maslohaslo1234-spec/electrotrack/BOM.md

# electrotrack – bill of materials

<!-- Generated by Half Life from project cmuva2sdt0fjm01smhur2xi6g. Edits here are overwritten on the next sync. -->
<!-- Generated: 2026-10-11T20:52:01.765Z -->

> [!NOTE]
> This parts list is mirrored from [Half Life](https://halflife.hackclub.com). Editing it here will not change the platform's copy, and the next sync overwrites this file.

| Week | Tier | Parts funding |
| --- | --- | --- |
| Week 1 | Tier 1 | $30.00 |

| Part | What it's for | Qty | Unit | Total | Vendor |
| --- | --- | --- | --- | --- | --- |
| [PCB](https://jlcpcb.com) | connecting everything | 1 | $2.00 | $2.00 | [jlcpcb](https://jlcpcb.com) |
| [IRLZ44NPBF](https://botland.com.pl/n-mosfet/1950-n-mosfet-irlz44n-55v47a-tht-5szt-5904422373276.html) | Switches the 4 coils, plus 1 spare | 1 | $7.63 | $7.63 | [botland](https://botland.com.pl/n-mosfet/1950-n-mosfet-irlz44n-55v47a-tht-5szt-5904422373276.html) |
| [1N5819 Schottky diode](https://botland.com.pl/diody-schottky/178-dioda-schottky-1n5822-3a-40v-10-szt-5903351244497.html) | Protects the 5 V rail from USB back-feed | 1 | $1.38 | $1.38 | [botland](https://botland.com.pl/diody-schottky/178-dioda-schottky-1n5822-3a-40v-10-szt-5903351244497.html) |
| [XT30UPB-M XT30 PCB socket](https://botland.com.pl/zlacza-do-akumulatorow/24155-gniazdo-xt30u-f-zlacze-zenskie-wysokopradowe-5szt.html) | Battery input connector | 1 | $3.80 | $3.80 | [botland](https://botland.com.pl/zlacza-do-akumulatorow/24155-gniazdo-xt30u-f-zlacze-zenskie-wysokopradowe-5szt.html) |
| [JST XH XHP-3 housing](https://botland.com.pl/zlacza-raster-254mm/19558-zestaw-zlacz-justpi-jst-xh254-2345-pin-meskiezenskie-i-pinow-zenskich-do-obudowy-gniazda-230szt-5904422328559.html) | Plugs for the IR sensor cables | 1 | $5.87 | $5.87 | [botland](https://botland.com.pl/zlacza-raster-254mm/19558-zestaw-zlacz-justpi-jst-xh254-2345-pin-meskiezenskie-i-pinow-zenskich-do-obudowy-gniazda-230szt-5904422328559.html) |
| **Parts subtotal** | — | — | — | **$20.68** | — |
| **Tax & shipping** | — | — | — | **$8.00** | — |
| **Total** | — | — | — | **$28.68** | — |

$1.32 left of the tier's funding.
