maslohaslo1234-spec/electrotrack/BOM.csv

Item | Qty | Supplier | Cost/item | Total Cost | link
PCB | 1 | jlcpcb | $2.00 | $2.00 | https://jlcpcb.com
IRLZ44NPBF | 1 | botland | $7.63 | $7.63 | https://botland.com.pl/n-mosfet/1950-n-mosfet-irlz44n-55v47a-tht-5szt-5904422373276.html
1N5819 Schottky diode | 1 | botland | $1.38 | $1.38 | https://botland.com.pl/diody-schottky/178-dioda-schottky-1n5822-3a-40v-10-szt-5903351244497.html
XT30UPB-M XT30 PCB socket | 1 | botland | $3.80 | $3.80 | https://botland.com.pl/zlacza-do-akumulatorow/24155-gniazdo-xt30u-f-zlacze-zenskie-wysokopradowe-5szt.html
JST XH XHP-3 housing | 1 | botland | $5.87 | $5.87 | https://botland.com.pl/zlacza-raster-254mm/19558-zestaw-zlacz-justpi-jst-xh254-2345-pin-meskiezenskie-i-pinow-zenskich-do-obudowy-gniazda-230szt-5904422328559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
Estimated total shipping | 1 |  |  | $8.00
