maslohaslo1234-spec/electrotrack/hardware/electrotrack.csv

Id | Designator | Footprint | Quantity | Designation | Supplier and ref
1 | C1 | CP_Radial_D10.0mm_P5.00mm | 1 | electrolitic 1000μF
2 | C2 | C_Disc_D5.0mm_W2.5mm_P5.00mm | 1 | C 100nF
3 | C3 | CP_Radial_D6.3mm_P2.50mm | 1 | 100 µF
4 | C4 | C_Disc_D5.0mm_W2.5mm_P5.00mm | 1 | 100nF
5 | D1, D2, D3, D4 | D_DO-201AD_P15.24mm_Horizontal | 4 | SB560
6 | D5 | D_DO-41_SOD81_P10.16mm_Horizontal | 1 | 1N5819
7 | F1 | Fuseholder_Clip-5x20mm_Littelfuse_520_Inline_P20.50x5.80mm_D1.30mm_Horizontal | 1 | 5A fast
8 | J1, J2, J3, J4 | JST_XH_B3B-XH-A_1x03_P2.50mm_Vertical | 4 | IR
9 | J5 | AMASS_XT30UPB-M_1x02_P5.0mm_Vertical | 1 | XT30
10 | J6, J7, J8, J9 | TerminalBlock_Phoenix_MKDS-1,5-2-5.08_1x02_P5.08mm_Horizontal | 4 | Coil
11 | J10 | PinSocket_1x04_P2.54mm_Vertical | 1 | 0.96 inch OLED
12 | J11 | PinSocket_1x10_P2.54mm_Vertical | 1 | Conn_01x10_Pin
13 | Q1, Q2, Q3, Q4 | TO-220-3_Vertical | 4 | IRLZ44N
14 | R1, R2, R3, R4 | R_Axial_DIN0207_L6.3mm_D2.5mm_P10.16mm_Horizontal | 4 | 10k Ω
15 | R5, R6, R7, R8 | R_Axial_DIN0207_L6.3mm_D2.5mm_P10.16mm_Horizontal | 4 | 150Ω
16 | R9, R10, R11, R12 | R_Axial_DIN0207_L6.3mm_D2.5mm_P10.16mm_Horizontal | 4 | 100Ω
17 | R13, R14, R15, R16 | R_Axial_DIN0207_L6.3mm_D2.5mm_P10.16mm_Horizontal | 4 | 10kΩ
18 | SW1 | TerminalBlock_Phoenix_MKDS-1,5-2-5.08_1x02_P5.08mm_Horizontal | 1 | SW_SPST
19 | U1 | ESP32_30pin | 1 | ~
20 | U2 | TO-220-3_Vertical | 1 | L7805
