maslohaslo1234-spec/electrotrack/pdf/electrotrack-B_Mask.pdf

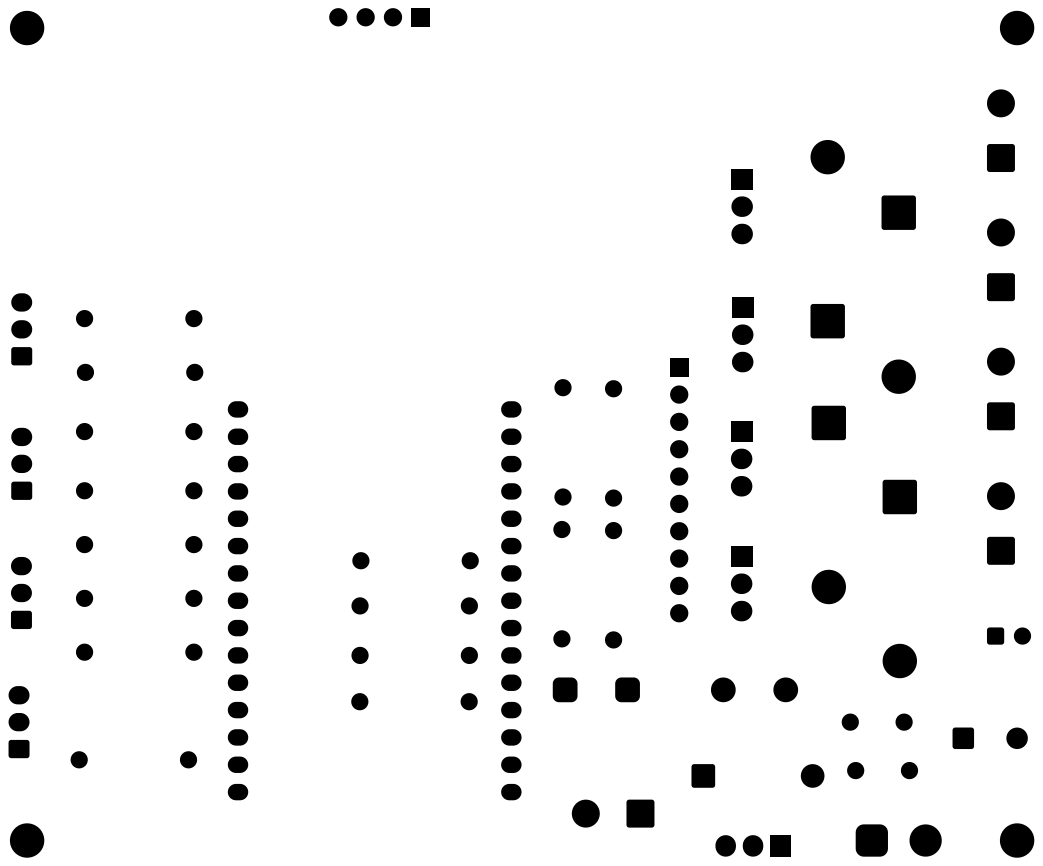
[picture p1: page 1]
