maslohaslo1234-spec/electrotrack/pdf/electrotrack-Back.pdf

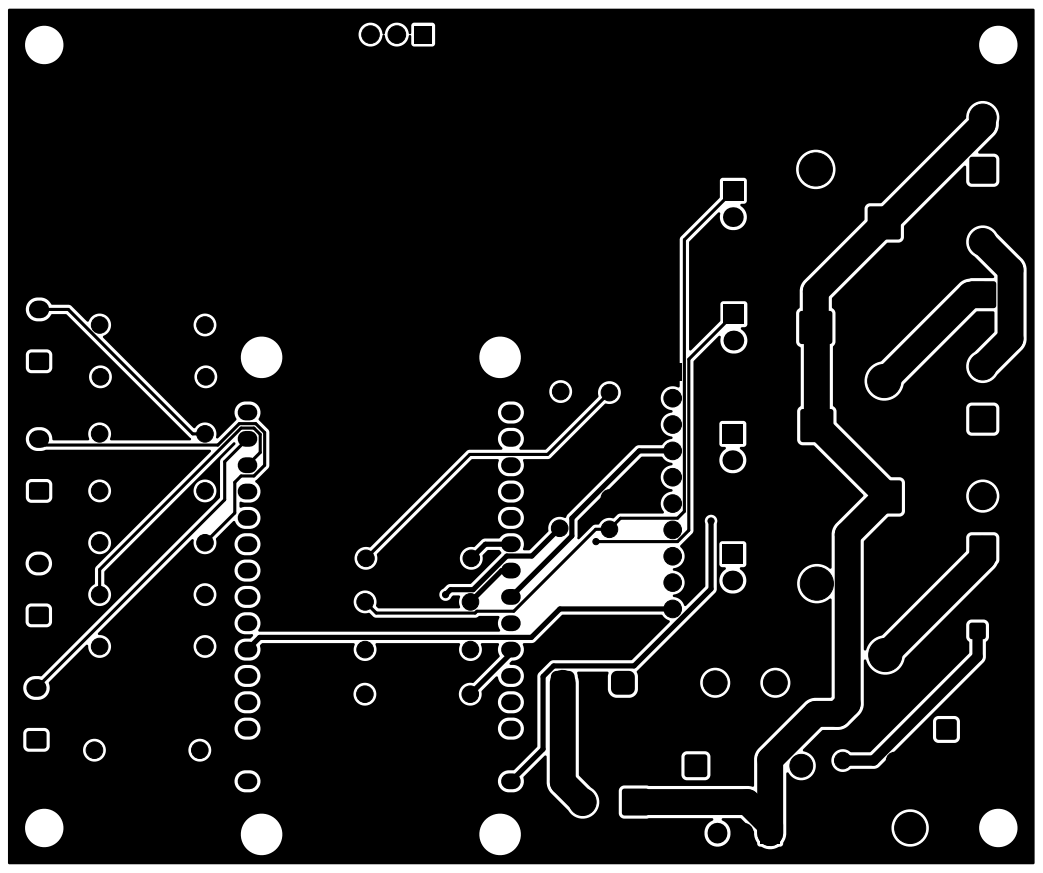
[picture p2: page 1]
