maslohaslo1234-spec/electrotrack/pdf/electrotrack-Edge_Cuts.pdf

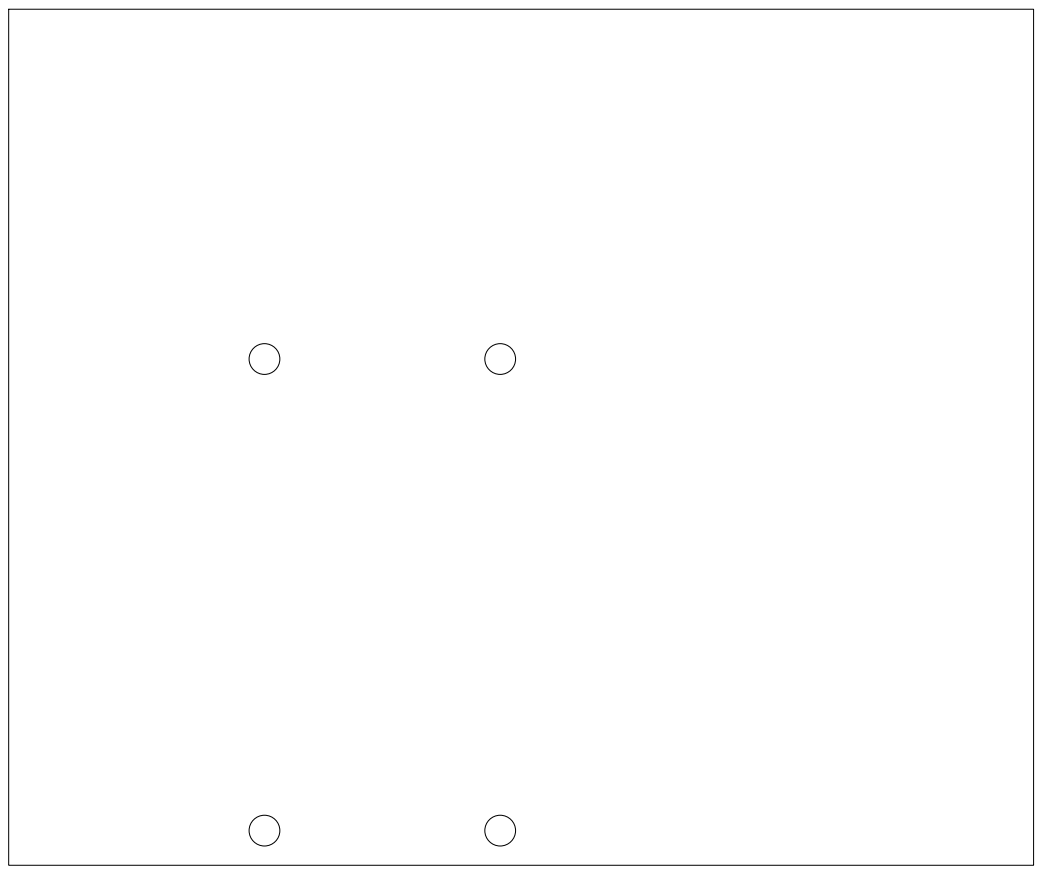
[picture p3: page 1]
