maslohaslo1234-spec/electrotrack/pdf/electrotrack-F_Silkscreen.pdf

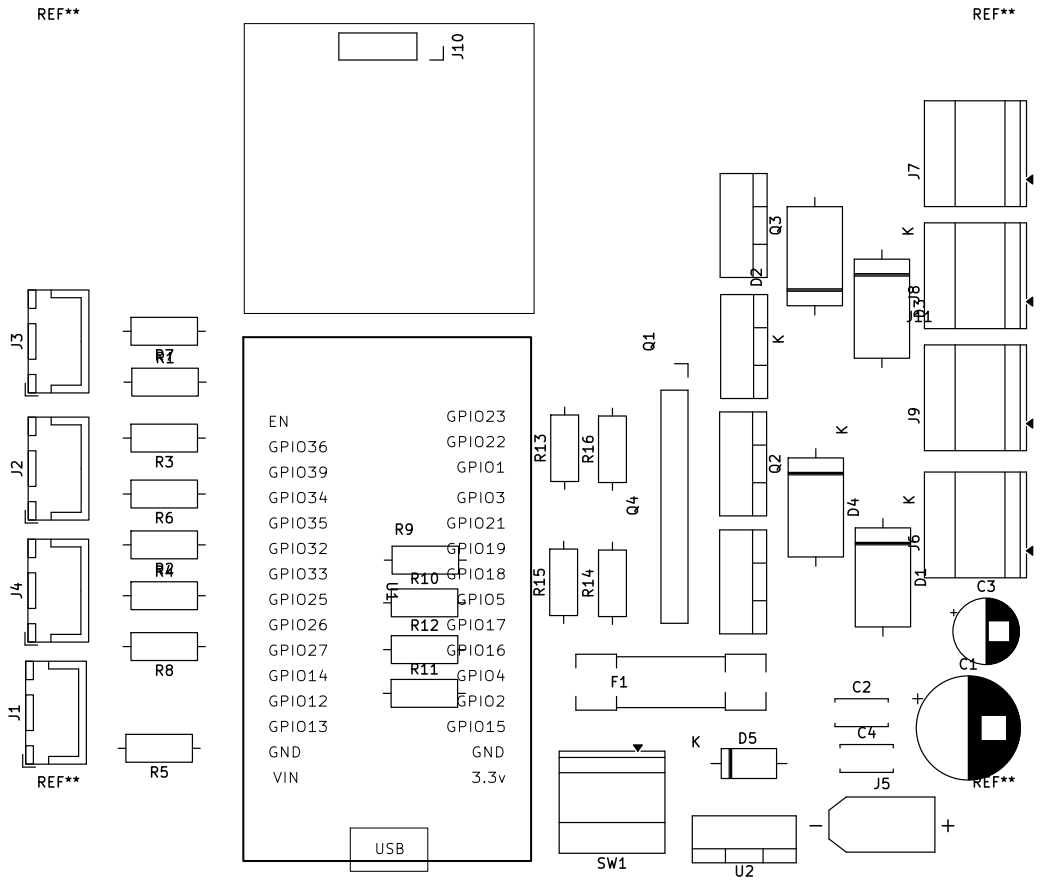
[picture p4: page 1]
