maslohaslo1234-spec/electrotrack/pdf/electrotrack-Front.pdf

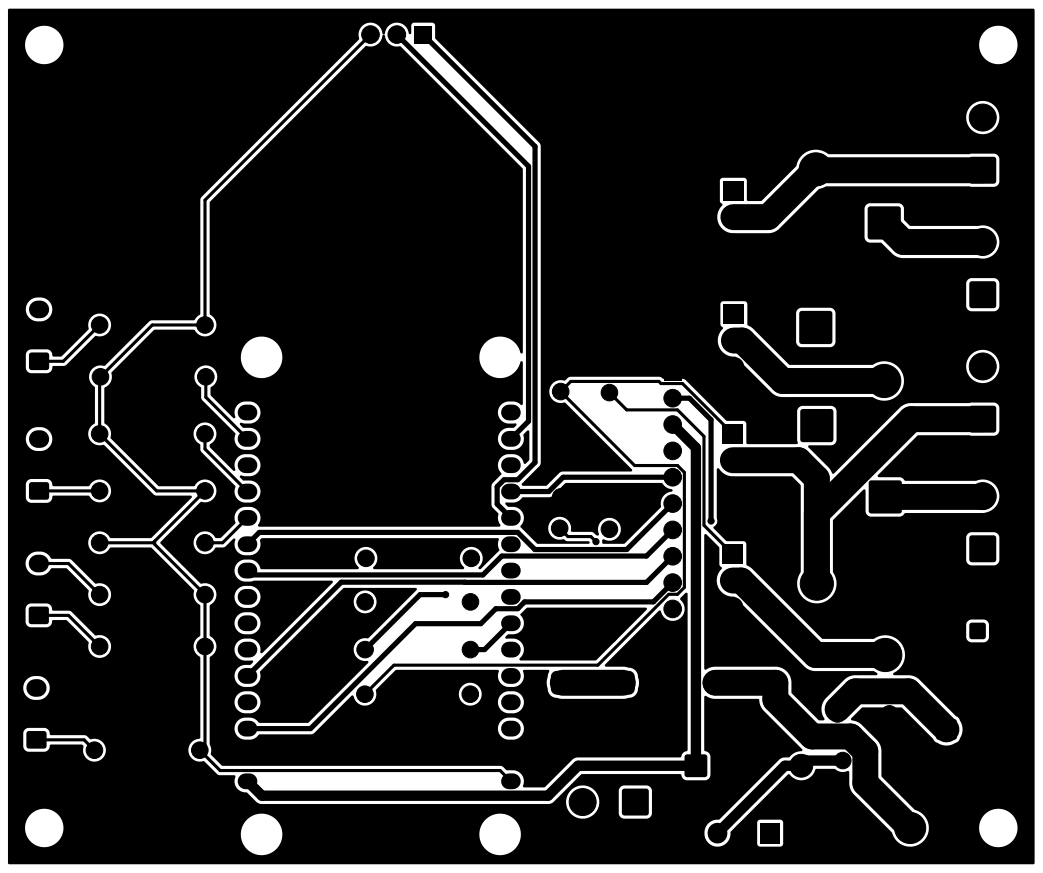
[picture p5: page 1]
