maslohaslo1234-spec/electrotrack/hardware/electrotrack.kicad_pcb

## KiCad design hardware/electrotrack.kicad_pcb (2026-10-11)

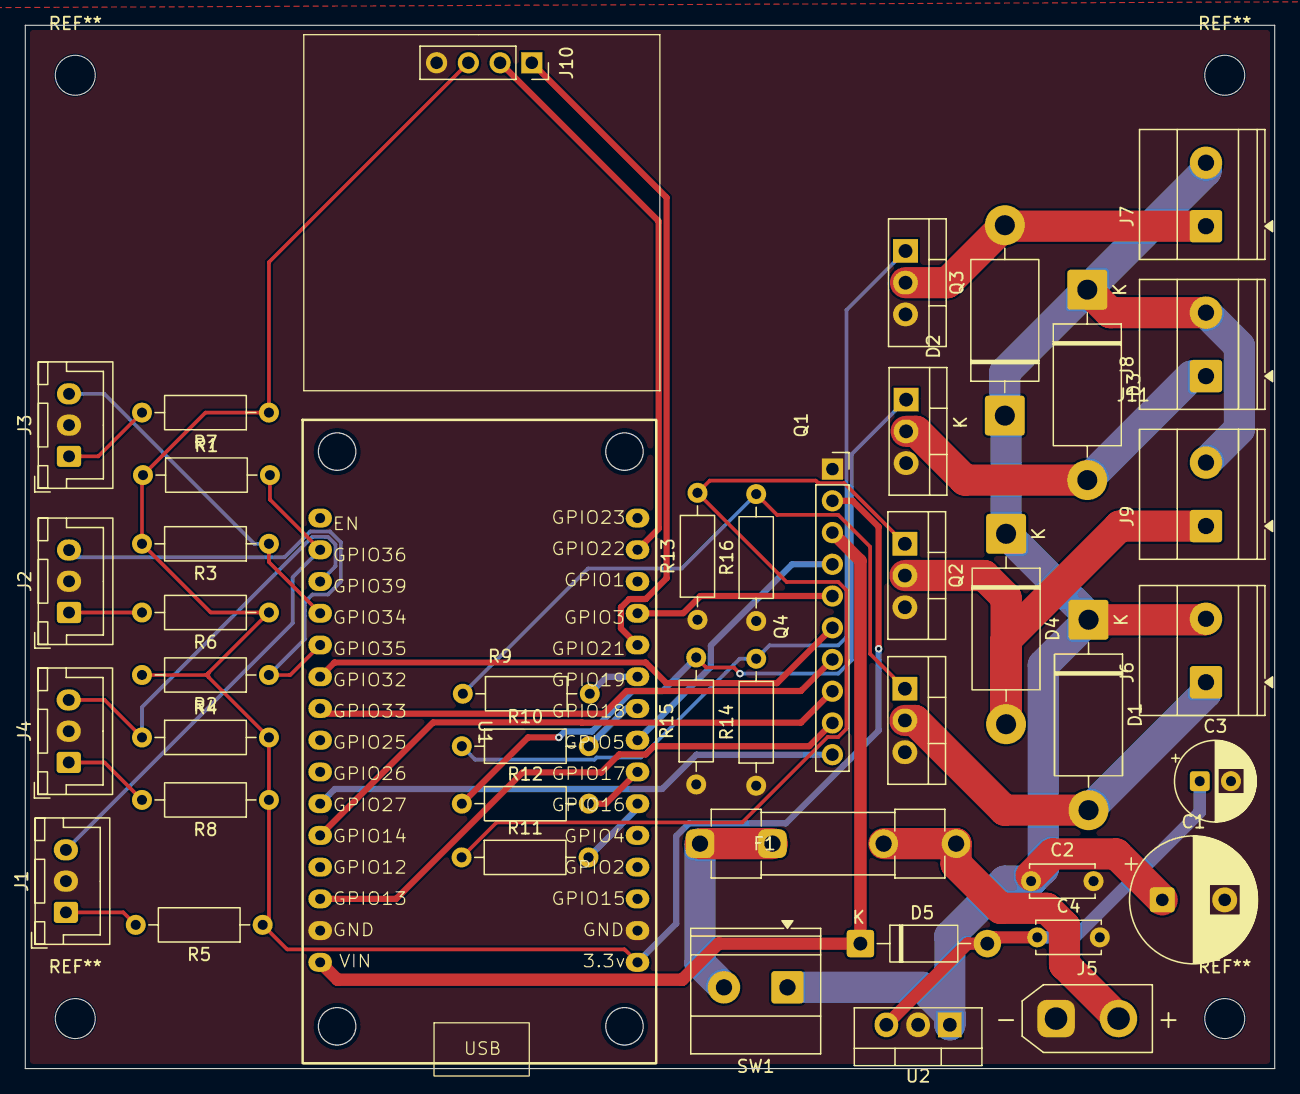
[picture p6: board electrotrack.kicad_pcb from above]

Board: 2 copper layers, 100.0 x 83.5 mm, 44 parts (0 on the bottom side), 36 nets.

Parts:
C1: electrolitic 1000μF; CP_Radial_D10.0mm_P5.00mm
C2: C 100nF; C_Disc_D5.0mm_W2.5mm_P5.00mm
C3: 100 µF; CP_Radial_D6.3mm_P2.50mm
C4: 100nF; C_Disc_D5.0mm_W2.5mm_P5.00mm
D1, D2, D3, D4: SB560; D_DO-201AD_P15.24mm_Horizontal
D5: 1N5819; D_DO-41_SOD81_P10.16mm_Horizontal
F1: 5A fast; Fuseholder_Clip-5x20mm_Littelfuse_520_Inline_P20.50x5.80mm_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
J1, J2, J3, J4: IR; JST_XH_B3B-XH-A_1x03_P2.50mm_Vertical
J5: XT30; AMASS_XT30UPB-M_1x02_P5.0mm_Vertical
J6, J7, J8, J9: Coil; TerminalBlock_Phoenix_MKDS-1,5-2-5.08_1x02_P5.08mm_Horizont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
J10: 0.96 inch OLED; PinSocket_1x04_P2.54mm_Vertical
J11: Conn_01x10_Pin; PinSocket_1x10_P2.54mm_Vertical
Q1, Q2, Q3, Q4: IRLZ44N; TO-220-3_Vertical
R1, R2, R3, R4: 10k Ω; R_Axial_DIN0207_L6.3mm_D2.5mm_P10.16mm_Horizontal
R5, R6, R7, R8: 150Ω; R_Axial_DIN0207_L6.3mm_D2.5mm_P10.16mm_Horizontal
R9, R10, R11, R12: 100Ω; R_Axial_DIN0207_L6.3mm_D2.5mm_P10.16mm_Horizontal
R13, R14, R15, R16: 10kΩ; R_Axial_DIN0207_L6.3mm_D2.5mm_P10.16mm_Horizontal
SW1: SW_SPST; TerminalBlock_Phoenix_MKDS-1,5-2-5.08_1x02_P5.08mm_Horizont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
U1: ESP32_30pin
U2: L7805; TO-220-3_Vertical

Connections:
+3.3V: J10.3, J11.2, R1.1, R2.2, R3.2, R4.2, R5.1, R6.1, R7.1, R8.1, U1.16 (3.3v)
+5V: D5.1 (K), J11.3, U1.1 (VIN)
+12V: C1.1, C2.1, D1.1 (K), D2.1 (K), D3.1 (K), D4.1 (K), J6.2, J7.2, J8.2, J9.2, SW1.1 (A), U2.1 (IN)
GND: C1.2, C2.2, C3.2, C4.2, J1.2, J2.2, J3.2, J4.2, J5.1, J10.4, J11.1, Q1.3 (S), Q2.3 (S), Q3.3 (S), Q4.3 (S), R13.1, R14.1, R15.1, R16.1, U1.2 (GND), U1.17 (GND), U2.2 (GND)
unnamed: D1.2 (A), J6.1, Q4.2 (D)
unnamed: D2.2 (A), J7.1, Q3.2 (D)
unnamed: D3.2 (A), J8.1, Q1.2 (D)
unnamed: D4.2 (A), J9.1, Q2.2 (D)
unnamed: C3.1, C4.1, D5.2 (A), U2.3 (OUT)
unnamed: J1.1, R5.2
unnamed: J1.3, R1.2, U1.14 (GPIO36)
unnamed: J2.1, R6.2
unnamed: J2.3, R2.1, U1.11 (GPIO35)
unnamed: J3.1, R7.2
unnamed: J3.3, R3.1, U1.12 (GPIO34)
unnamed: J4.1, R8.2
unnamed: J4.3, R4.1, U1.13 (GPIO39)
unnamed: F1.2, J5.2
unnamed: J10.1, U1.26 (GPIO21)
unnamed: J10.2, U1.29 (GPIO22)
unnamed: J11.4, U1.23 (GPIO5)
unnamed: J11.5, U1.27 (GPIO3)
unnamed: J11.6, U1.10 (GPIO32)
unnamed: J11.7, U1.9 (GPIO33)
unnamed: J11.8, U1.5 (GPIO14)
unnamed: J11.9, U1.3 (GPIO13)
unnamed: J11.10, U1.6 (GPIO27)
unnamed: Q1.1 (G), R12.1, R15.2
unnamed: Q2.1 (G), R11.1, R13.2
unnamed: Q3.1 (G), R10.1, R14.2
unnamed: Q4.1 (G), R9.1, R16.2
unnamed: F1.1, SW1.2 (B)
unnamed: R11.2, U1.21 (GPIO16)
unnamed: R12.2, U1.22 (GPIO17)
unnamed: R10.2, U1.24 (GPIO18)
unnamed: R9.2, U1.25 (GPIO19)
