maslohaslo1234-spec/electrotrack/JOURNAL.md

# electrotrack – devlog

<!-- Generated by Half Life from project cmuva2sdt0fjm01smhur2xi6g. Edits here are overwritten on the next sync. -->
<!-- Generated: 2026-10-11T19:37:45.149Z -->

> [!NOTE]
> This devlog is mirrored from [Half Life](https://halflife.hackclub.com) – [open the project](https://halflife.hackclub.com/projects/cmuva2sdt0fjm01smhur2xi6g). Editing it here will not change the platform's copy, and the next sync overwrites this file.

> Electrotrack is a multi-stage electromagnetic ball accelerator (coilgun) with a custom PCB. An ESP32 reads IR photo-interrupters along a 3D-printed track and fires a sequence of coils to pull a steel ball forward. Each coil is switched off as the ball reaches its center, so it isn't pulled back. Hardware - ESP32 controller, 4 coil channels (logic-level N-MOSFETs + flyback diodes) - Coils wound from 0.3 mm copper wire - 3S LiPo (≈12 V)  - IR position sensors salvaged from a photocopier - 7.5 mm steel ball *Inspired by Hyperspace Pirate's electromagnetic accelerator project.*

| Week | Tier | Hours logged | Entries |
| --- | --- | --- | --- |
| Week 1 | Tier 1 | 21.68h | 2 |

## Contents

1. [2026-10-06 – ## Week 1 – Entry 1: Concept, schematic and idea reel](#2026-10-06-week-1-entry-1-concept-schematic-and-idea-reel)
2. [2026-10-11 – Week 1 – Entry 2: KiCad schematic, PCB layout and routing](#2026-10-11-week-1-entry-2-kicad-schematic-pcb-layout-and-rou)

## Design

### 2026-10-06 – ## Week 1 – Entry 1: Concept, schematic and idea reel

**10h**

## Week 1 – Entry 1: Concept, schematic and idea reel

**Total time: ~10 h over two days**

* ~2.5 h: hand-drawn schematic + research
* ~2.5 h: thinking through decisions + filming initial clips
* ~3.5 h: filming remaining footage & editing the reel
* ~1.5 h: writing & publishing Entry 1
---

### Day 1 (05.10, 4:00pm–9:00pm): Ideas, decisions and schematic

**How it started**
I watched Hyperspace Pirate's video *"Electromagnetic Accelerator Improvements Part II"* and realized that building something similar was well within reach. That's when I decided to make it my Half-Life project, featuring a custom PCB to control the system.

> *Inspiration: Hyperspace Pirate's Electromagnetic Accelerator project*
inspiration

**Design decisions**

- **Power:** 3S LiPo battery (already on hand).
- **Coils:** Wound from 0.3 mm copper wire (plenty available). Planning 4 coils for the initial setup.

> *Coils match-cut*
coils

> *0.3 mm copper wire spool and 3S LiPo battery*
wire and battery

- **Projectile:** Found two steel balls (7.5 mm and 12 mm). Testing both to determine the optimal choice.

> *Candidate projectiles: 7.5 mm and 12 mm steel balls*
Projectile

- **Mechanics:** 3D-printed guide track and structure.
- **Controller:** ESP32 microcontroller instead of a purely analog timing circuit. It provides precise timing control and allows dedicated firmware development.

> *ESP32 microcontroller board match-cut*
esp32

- **Sensors:** Salvaged IR photo-interrupters from an old photocopier, eliminating the need to purchase new sensors.

> *IR sensors match-cut*
IR

> *Close-up of the salvaged IR sensor components*
IR sens

**Schematic**
I carefully drew the complete circuit by hand on paper (~3 hours including research): featuring an ESP32, 4 MOSFET channels, coil drivers with flyback diodes, IR position sensors, and power regulation (12 V input to L7805 5 V regulator feeding the ESP32 VIN). The rest of the afternoon was spent refining decisions and recording footage for the video reel.

> *Drafting the circuit schematic by hand*


> *Completed hand-drawn schematic diagram*
schematic

**Problems & Solutions**

- **Bare IR sensors:** They consist only of raw IR LEDs and phototransistors. Added 220 Ω current-limiting resistors for LEDs and 10 kΩ external pull-up resistors for phototransistors, as ESP32 input-only pins lack internal pull-ups.
- **Powering ESP32 from 12 V:** Lacking a buck converter, I utilized an L7805 linear regulator. Heat dissipation will be managed with a small heatsink.
- **ESP32 pin selection:** Avoided strapping pins during boot and mapped all IR sensor inputs to dedicated input-only pins (GPIs).

---

### Day 2 (06.10, 8:30am–12:45pm): The idea reel

I dedicated the entire morning session to producing the video reel. With limited video editing experience, polishing the video took considerable time. This is my first fully edited project video in English.

- Executed a clean match-cut transition from the paper schematic to physical components.

> *Match-cut transition: paper schematic to real hardware*
match cut

---

### Day 2 (06.10, 6:30pm–8:00pm): Entry 1

Finalized and published the Entry 1 log, organizing footage, GIF demonstrations, and technical documentation.

---

### Still to check / Next steps

- Measure coil DC resistance and calculate peak current draw at 12 V (0.3 mm wire has low DC resistance).
- Select MOSFET gate resistors and pull-down resistors.
- **Next:** Transfer schematic to KiCad, generate the Bill of Materials (BOM), and layout the PCB.

### 2026-10-11 – Week 1 – Entry 2: KiCad schematic, PCB layout and routing

**11.68h**

Week 1 – Entry 2: KiCad schematic, PCB layout and routing
Total time: ~7.2 h (recorded in timelapses)

* ~3 h: KiCad schematic, footprints and BOM
* ~2 h: component placement + OLED and spare-GPIO headers
* ~1 h: routing the 2-layer board
* ~1 h: DRC fixes, Gerber/BOM export and GitHub repo
* ~1 h: editing the timelapse reel & writing Entry 2

Day 3 (07.10): KiCad schematic, footprints and BOM
I redrew the hand-drawn schematic in KiCad: ESP32 30-pin devkit, 4 coil channels (IRLZ44N MOSFET, 100 ohm gate resistor, 10k pull-down, SB560 flyback diode), 4 IR sensor inputs (JST XH connectors with resistors), 12 V input through an XT30 connector with fuse and switch, and an L7805 for 5 V.

schematic

KiCad schematic

Then I assigned footprints and exported the BOM.

footprint

Footprints assigned and loaded into the PCB editor

Day 4 (08.10): Component placement
I placed all components on the board, then added two extras: a 0.96" I2C OLED header (SDA on GPIO21, SCL on GPIO22) to show ball speed, and a 1x10 header with spare GPIOs, 3.3 V and GND for future needs.

Day 5 (10.10): Tidying the layout
I regrouped the parts: each coil channel in one row (terminal, flyback diode, MOSFET, resistors), power input and capacitors in one corner, ESP32 with the USB port at the board edge, and IR connectors on the opposite side.

Day 6 (11.10): Routing, DRC and fabrication files
I routed a 2-layer board: 2.5 mm traces for 12 V, 1.5-2.5 mm for coil nets, 0.3-0.5 mm for signals, and a GND copper pour on both layers. Then I ran DRC and fixed all errors (thermal relief errors solved with solid pad connections, plus one unconnected GND pad). Only silkscreen warnings are left. Finally I exported Gerbers, drill files, BOM and schematic, and pushed everything to GitHub.

3d

3D view of the finished PCB

Problems & Solutions

* Wrong layer count: the imported JLCPCB template had 4 copper layers. I switched the board to 2 layers in Board Setup.
* XT30 polarity: the + and - were swapped between my schematic and the footprint. I fixed it in the schematic before routing.
* MOSFET gate drive: the IRLZ44N gate is driven from 3.3 V, but the datasheet specifies its on-resistance only for 4-5 V. I decided to keep it for this version and measure the drain-source voltage when I build it. A gate driver can be added later if needed.
* DRC errors: the GND pour used a 0.5 mm clearance and thermal reliefs, which left some pads under-connected. Changing it to a 0.3 mm clearance and solid pad connections fixed all errors.
* Gate and pull-down resistors (open item from Entry 1): chose 100 ohm gate resistors and 10k pull-downs, so the MOSFETs stay off while the ESP32 boots.
* IR LED resistors: the schematic uses 150 ohm from 3.3 V (about 14 mA, assuming about 1.2 V forward voltage) instead of the 220 ohm I first planned. I will verify this with the real sensors.

Still to check / Next steps

* Measure the coil DC resistance and check that the 5 A fuse matches the peak current.
* Measure the MOSFET drain-source voltage with a 3.3 V gate drive during a coil pulse.
* Check how hot the L7805 gets.
* Firmware must limit the on-time of each coil.
* Order the PCB and parts after approval, wind the coils and 3D-print the track.

Additional hours (not covered by the timelapses)
The extra hours I added to this entry (~2 h in total) come from work that is not on the timelapses:

* ~0.5 h: editing the progress reel
* ~0.5 h: writing Entry 2
* ~1 h: adding footprints (assigning footprints and drawing the custom ESP32 footprint), which I did not record

CHANGES MADE AFTER REVIEW (resubmission)
The project was reviewed and returned with "Design needs changes". Everything in this section was done AFTER that review, in response to the reviewer's feedback.

Reviewer feedback:
1. Make the README more descriptive: what the project is, what it does / what its purpose is, and why it exists.
2. Start writing the firmware now.

Time spent on these changes: ~2.5 h (~1.5 h README, ~1 h firmware), not covered by the timelapses.

1) README: more descriptive (~1 h)
* Added sections explaining what Electrotrack is, what it is intended to do and why I am building it (inspired by Hyperspace Pirate's videos, and a way to learn the full path from schematic to PCB, CAD, firmware and prototype).
* Added a hardware overview, a project files table, a status checklist and ESP32 connections
* Added a Firmware section to the README (see below).


2) Firmware: first draft (~1 h)
The firmware is in the repo at software/firmware/firmware.ino and is described in the "Firmware" section of the README. It was written with AI assistance (vibe coding), and the README says so clearly. It has not been tested on hardware yet.
* An IR sensor sits just before each coil. When the ball is detected, an interrupt switches that coil on and schedules the switch-off for when the ball reaches the coil centre, based on the speed measured between the previous two sensors.
* A high-priority task waits for the switch-off time with microsecond precision, so the timing does not depend on the 1 ms FreeRTOS tick.
* Software safety: 80 ms maximum on-time per coil, the previous coil is forced off when the next sensor fires, a run stops after 400 sensor events, and any fault switches all coils off until the next start.
* The OLED shows the current speed, peak speed and hit count. BOOT starts and stops a run.
* The code has a setting IR_TRIGGER EDGE) that lets it be tried in an online simulator with push buttons instead of the IR sensors.
* After writing the draft I reviewed it against the schematic and fixed two problems: the IR pin order in the code was outdated (now 36, 35, 34, 39 for J1-J4), and the coil timeout check in loop() could report a false fault because of a timing race with the interrupt. I also tidied the code.



Next steps for the firmware: test it on the real board, tune the switch-off timing and update the geometry values (sensor spacing, sensor-to-coil-centre distance)

[Timelapse](https://lookout.hackclub.com/api/media/6e4bf680-f906-4f02-b66c-daf962ac259b/video.mp4)

[Timelapse](https://lookout.hackclub.com/api/media/16be31a1-edc4-4971-941b-b980e7b303be/video.mp4)

[Timelapse](https://lookout.hackclub.com/api/media/2f933883-cecd-4e28-ad8b-e76392387738/video.mp4)
