maslohaslo1234-spec/electrotrack/(commit log)

2026-10-07 added schematic
    [electrotrack.kicad_sch]
2026-10-11 finished PCB
2026-10-19 Expand README with ESP32 connection details
    Added detailed ESP32 connection information for IR sensors and OLED display in the README.
